Kaiwol1990/Mechaduino/schematics.png

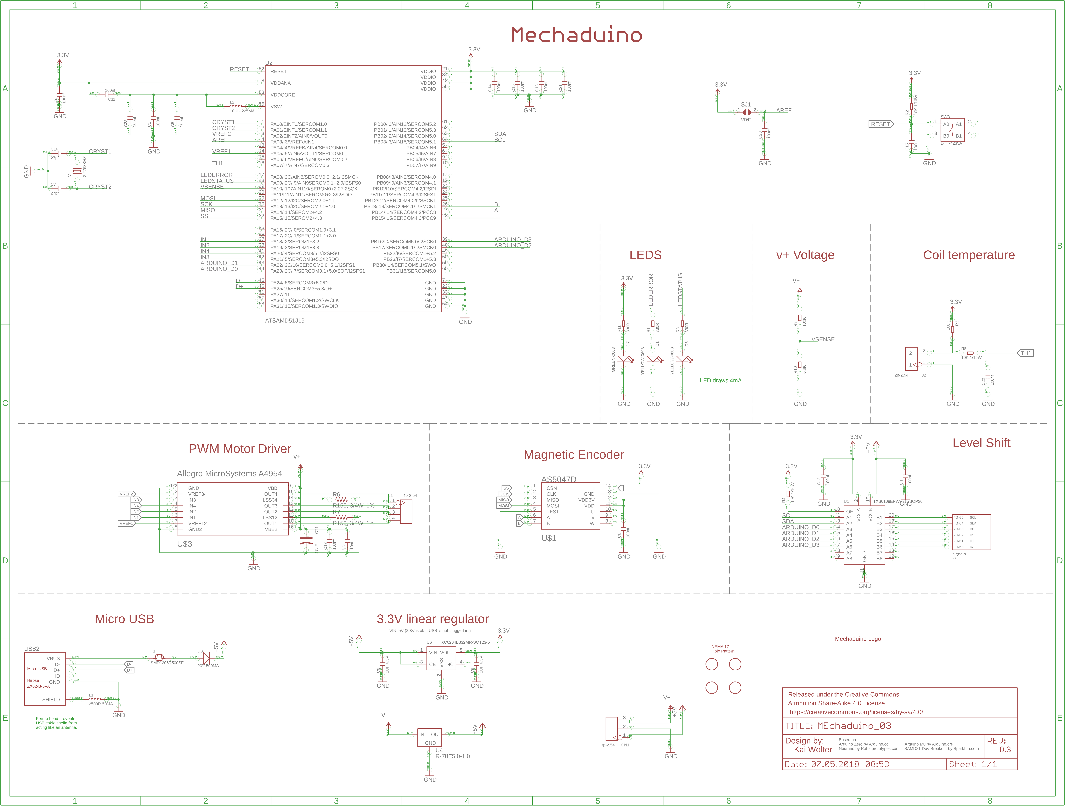
schematics.png
