Kaiwol1990/Mechaduino/(threads)

Thread 4 (2017-03-12):

Robodyn SAMD21 MINI board

LordVila, 2017-03-12:
Hello Kaiwol1990, first let me thank you for your help to the stepper servo drive world!

I'm currently working on a design based on the Mechaduino but for largers motors, using discrete MOSFETs instead of a dual H-bridge IC drive.

Got a Robodyn SAMD21 MINI board, since use the same microcontroller, and tried to upload your modified code version of Mechaduino but I'm not getting anything on the serial monitor, while the original code from Mechaduino works great. Any idea what could it be?

Kaiwol1990, 2017-03-25:
Hi LordVila,

sry for not answering. I'm not sure why you aren't getting anything from the SerialPort.
It's basically using the same Port as the original Firmware. Make sure you set the baudrate right and change your Serialparser to send a "\n" after every new line.

Closed 2017-04-08.

Thread 9 (2017-08-22):

0.9 degree stepper not working

Elvenblood, 2017-08-22:
Hi,

I can't get my 0.9 stepper to work with this release. It works somewhat better with the old version.
It runs through the calibration-process, but i get maximal error of around 70%. But I don't get any data for the lookup table and it sort of hangs.

With this version when trying to calibrate I get: "...Motor is not moving -> abbort"
It starts to move but don't really move at all, just oscillates.

Also, mm_rev what should the correct value be?

Thanks for any info

Kaiwol1990, 2017-08-23:
Hi Elvenblood,

I will take a look at what's going on. There are some bugs in the calibration routine I think.

The mm_rev value is only needed for the maximal error term and for the velocity settings of the downhill simplex algorithm. It's used for a motor with a pulley. If you don't have a pulley that turns the rotation into a linear movement, just set it to 360 and the velocity can be set in deg/s.

Kaiwol1990, 2017-08-23:
I've uploaded a new Version to the dev branch. Can you please try it for me?
If it's still not working try the command "calibrate -debug" and upload the output as a file.

Elvenblood, 2017-08-23:
Thanks for your help. Right now I had to get my 3d printer operational again so I switched back to my old setup. But I will try it as soon as I can. Probably this weekend. I tried it with 1.8 degrees with slightly better results. After a couple of layers it all jumps a few steps in som direction and I need to stop the print. This is the 3rd time I've tried to use the mechaduino and the 3rd set of motors, so I slowly loose hope of ever getting it to work.

I have 20 tooth gt2 pulleys and belts for my core-xy printer running it with 16 microstepping. What should the mm be then?

Thanks again and I'll try to give you the result as soon as I can.

Kaiwol1990, 2017-08-23:
The mm_rev would be 40 in that case.

The jumps could be a bad lookup table or bad PID settings. Make sure to try the downhill simplex algorithm to tune the motor. You can find it in the autotune tab.

Did you glue the magnet to the shaft as centered as possible?

_Sent from my OnePlus ONEPLUS A3003 using [FastHub](https://play.google.com/store/apps/details?id=com.fastaccess.github)_

Elvenblood, 2017-08-23:
Yes I tried the downhill which tuned it good as far as I could see. But I'll try it again. Yes I've tried glueing and not glueing and tweaking the mechaduino up down left right to no avail. I'll try to make a shim with my 3d printer and see if i can make it even more centered,

Btw nice work with firmwara end the GUI for tuning it. Makes the product a lot better.

/E

Kaiwol1990, 2017-08-24:
Thanks,
I glued the magnets all without a shim, just by hand and it works pretty well for me.
While tuning with the downhill simplex make sure to set the velocity to your average printing speed.
And while calibrating it is important that there is no load on the motors ( no belts attached) but I'm sure you know that. Let me know if it works.

- Kai

Elvenblood, 2017-08-26:
Hello,

The calibration now works. I don't know how accurate it is since the calibration report didn't show the number any more. How can I check the lookup table for errors?

Thanks for the fix. I'll run the downhill autotune later tonight and try som prints and see if it behaves.

/E

Kaiwol1990, 2017-08-27:
I've uploaded a new version to the dev branch.
if you send a "calibration -check" the mechaduino will step two times through all steps and checks the readings. You then can decide if you want to continue or not.
You can also send a "-smooth" with it to smooth the calibration table a little bit. This can help with a quieter operation of the mechaduino.

Kaiwol1990, 2017-08-28:
Hi Elvenblood,

I found another bug in the calibration. The coil current wasn't set right to do the full steps. I also implemented that the motor moves in both directions to compensate that it might want to move more in one direction.

Could you please check it?

Thanks.
Kai

Elvenblood, 2017-08-29:
Sorry for the late reply. But sure i'll try it as soon as I have moment over.

/E

Closed 2017-09-08.

Thread 12 (2020-01-26):

Incorrect handling of AS5047 ?

ctolzane, 2020-01-26:
Hi,
In order to make the readEncoderDiagnostics function to work I have to comment the lines below in Serial.cpp. Problem seen in master and dev branches. Why do you read twice?
Christophe.

**void readEncoderDiagnostics(int arg_cnt, char** args) {
	disableTC5Interrupts();
	disableTC4Interrupts();
	long angleTemp;

	SerialUSB.println(diagnostics_header);

	digitalWrite(chipSelectPin, HIGH);
	delay(1);
	digitalWrite(chipSelectPin, LOW);

	SPI.transfer(0xFF);
	SPI.transfer(0xFC);

	digitalWrite(chipSelectPin, HIGH);
	delay(1);
	digitalWrite(chipSelectPin, LOW);

	byte b1 = SPI.transfer(0xC0);
	byte b2 = SPI.transfer(0x00);

//	digitalWrite(chipSelectPin, HIGH);
//	delay(1);
//	digitalWrite(chipSelectPin, LOW);
//
//	b1 = SPI.transfer(0xC0);
//	b2 = SPI.transfer(0x00);**
