Kaiwol1990/Mechaduino/MEchaduino_03.brd

## EAGLE design MEchaduino_03.brd (2018-05-07)

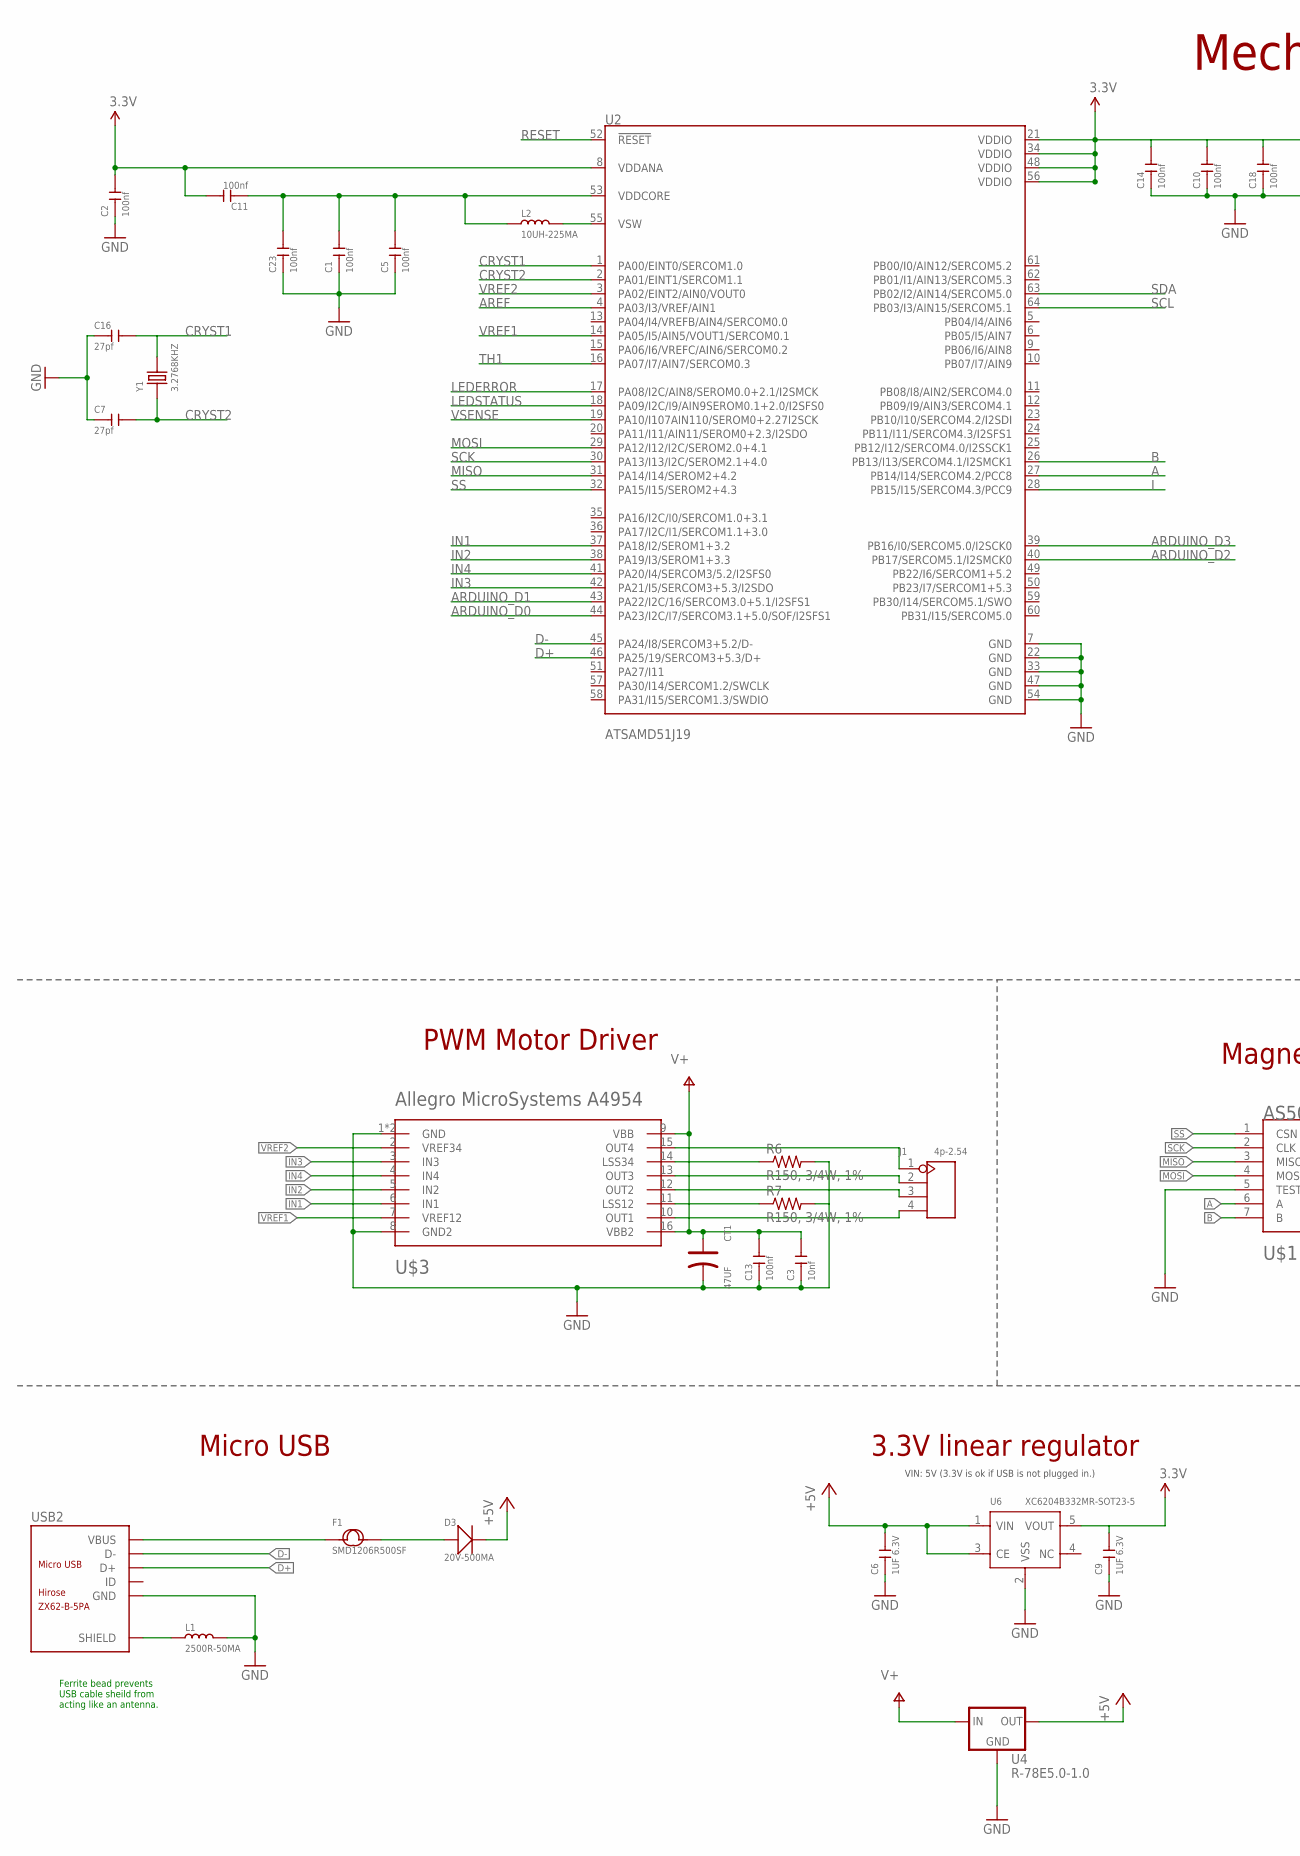
[picture p4: schematic MEchaduino_03.sch, part in row 1, column 1]

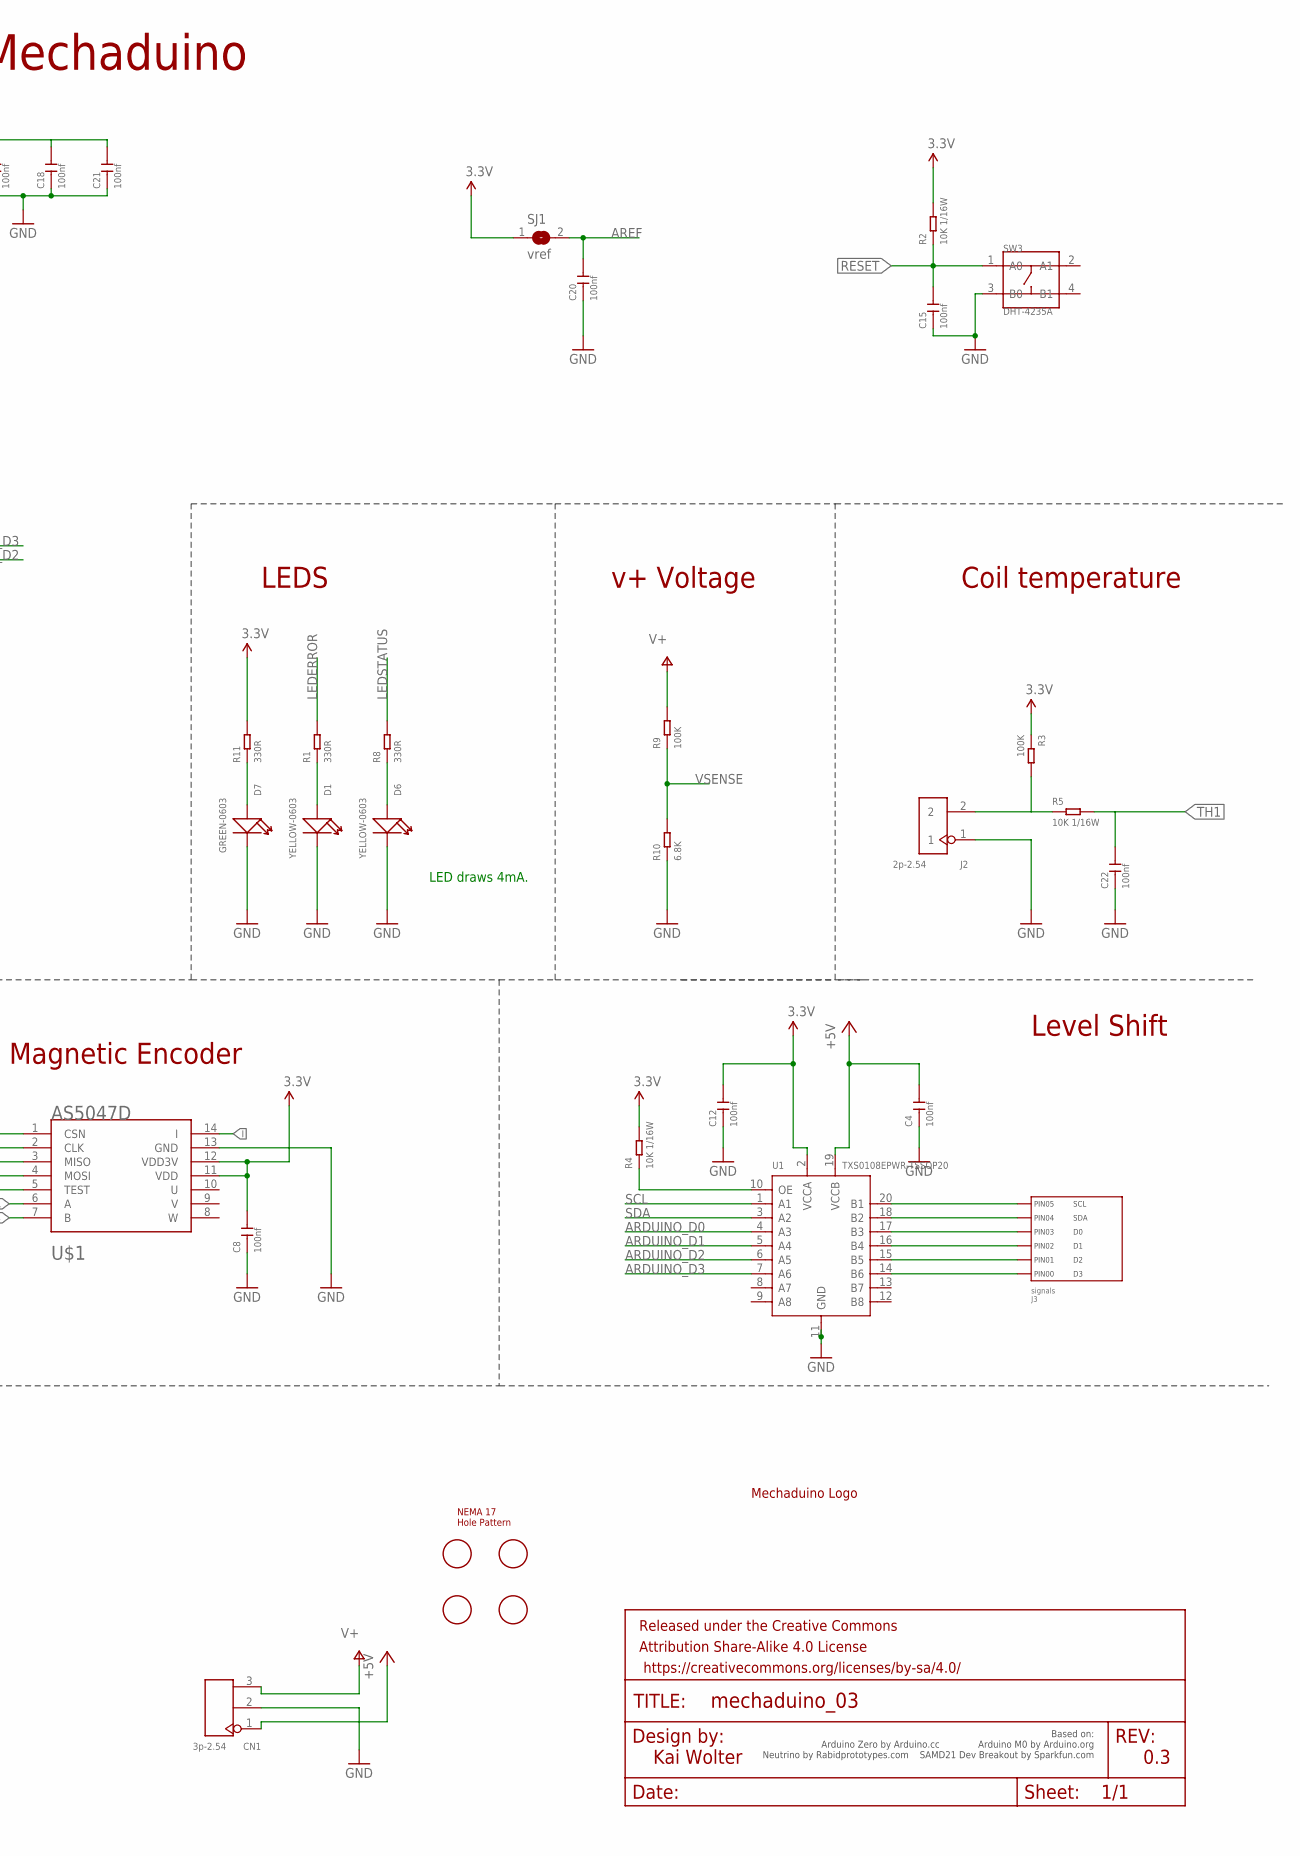
[picture p5: schematic MEchaduino_03.sch, part in row 1, column 2]

Parts:
C1, C2, C4, C5, C8, C10, C11, C12, C14, C15, C18, C20, C21, C22, C23: 100nf; C0402
C3: 10nf; C0603
C6, C9: 1UF 6.3V; C0402
C7, C16: 27pf; C0402
C13: 100nf; C0603
CN1: 3p-2.54; H3-2.54
CT1: 47UF; ELECTRO-SMD-C-6MM
D1, D6: YELLOW-0603; LED-0603
D3: 20V-500MA; SOD-123
D7: GREEN-0603; LED-0603
F1: SMD1206R500SF; F1206
FRAME1: FRAME-LEDGER; CREATIVE_COMMONS
J1: 4p-2.54; H4-2.54
J2: 2p-2.54; H2-2.54
J3: signals; PTH_2.54MM_01X06
L1: 2500R-50MA; L0603
L2: 10UH-225MA; L0806
R1, R8, R11: 330R; R0402
R2, R4, R5: 10K 1/16W; R0402
R3, R9: 100K; R0402
R6, R7: R150, 3/4W, 1%; R1206; MPN KRL1632E-M-R150-F-T5
R10: 6.8K; R0603
SJ1: vref; SJ
SW3: DHT-4235A; SW4-SMD-4.2X3.2X2.5MM
U1: TXS0108EPWR-TSSOP20; TSSOP20-0.65-6.5X4.4MM
U2: ATSAMD51J19; TQFP64; MPN ATSAMD51J19A-AU
U4: R-78E5.0-1.0; DC-DC_CONVERTER_78XX
U6: XC6204B332MR-SOT23-5; SOT-23-5
U$1: AS5047D; TSSOP14; MPN AS5047D-ATSM
U$2: NEMA17_HOLE_PATTERNNEW; NEMA17_HOLE_PATTERN_2
U$3: Allegro MicroSystems A4954; TSSOP16_THERM; MPN A4953ELJTR-T
U$4: MECHADUINO_LOGO
USB2: ZX62-B-5PA; MICRO-USB5+6P-SMD-0.65-AB
Y1: 3.2768KHZ; X2-SMD-L2.0X1.2X0.55MM

Connections:
3.3V: C2.2, C8.2, C9.2, C10.2, C11.2, C12.2, C14.2, C18.2, C21.2, R2.2, R3.1, R4.2, R11.2, SJ1.1, U1.2 (VCCA), U2.8 (VDDANA), U2.21 (VDDIO), U2.34 (VDDIO), U2.48 (VDDIO), U2.56 (VDDIO), U6.5 (VOUT), U$1.11 (VDD), U$1.12 (VDD3V)
+5V: C4.2, C6.2, CN1.1, D3.-, U1.19 (VCCB), U4.VOUT (OUT), U6.1 (VIN), U6.3 (CE)
A: U2.27 (PB14/I14/SERCOM4.2/PCC8), U$1.6 (A)
ARDUINO_D0: U1.4 (A3), U2.44 (PA23/I2C/I7/SERCOM3.1+5.0/SOF/I2SFS1)
ARDUINO_D1: U1.5 (A4), U2.43 (PA22/I2C/16/SERCOM3.0+5.1/I2SFS1)
ARDUINO_D2: U1.6 (A5), U2.40 (PB17/SERCOM5.1/I2SMCK0)
ARDUINO_D3: U1.7 (A6), U2.39 (PB16/I0/SERCOM5.0/I2SCK0)
AREF: C20.2, SJ1.2, U2.4 (PA03/I3/VREF/AIN1)
B: U2.26 (PB13/I13/SERCOM4.1/I2SMCK1), U$1.7 (B)
CRYST1: C16.2, U2.1 (PA00/EINT0/SERCOM1.0), Y1.2
CRYST2: C7.2, U2.2 (PA01/EINT1/SERCOM1.1), Y1.1
D+: U2.46 (PA25/19/SERCOM3+5.3/D+), USB2.3 (D+)
D-: U2.45 (PA24/I8/SERCOM3+5.2/D-), USB2.2 (D-)
GND: C1.1, C2.1, C3.1, C4.1, C5.1, C6.1, C7.1, C8.1, C9.1, C10.1, C12.1, C13.1, C14.1, C15.1, C16.1, C18.1, C20.1, C21.1, C22.1, C23.1, CN1.2, CT1.-, D1.-, D6.-, D7.-, J2.1, L1.2, R6.2, R7.2, R10.1, SW3.3 (B0), U1.11 (GND), U2.7 (GND), U2.22 (GND), U2.33 (GND), U2.47 (GND), U2.54 (GND), U4.GND, U6.2 (VSS), U$1.5 (TEST), U$1.13 (GND), U$3.1 (GND), U$3.8 (GND2), U$3.P$1 (GND), USB2.5 (GND)
I: U2.28 (PB15/I15/SERCOM4.3/PCC9), U$1.14 (I)
IN1: U2.37 (PA18/I2/SEROM1+3.2), U$3.6 (IN1)
IN2: U2.38 (PA19/I3/SEROM1+3.3), U$3.5 (IN2)
IN3: U2.42 (PA21/I5/SERCOM3+5.3/I2SDO), U$3.3 (IN3)
IN4: U2.41 (PA20/I4/SERCOM3/5.2/I2SFS0), U$3.4 (IN4)
I_SENSE_COIL_A: R7.1, U$3.11 (LSS12)
I_SENSE_COIL_B: R6.1, U$3.14 (LSS34)
LEDERROR: R1.2, U2.17 (PA08/I2C/AIN8/SEROM0.0+2.1/I2SMCK)
LEDSTATUS: R8.2, U2.18 (PA09/I2C/I9/AIN9SEROM0.1+2.0/I2SFS0)
MISO: U2.31 (PA14/I14/SEROM2+4.2), U$1.3 (MISO)
MOSI: U2.29 (PA12/I12/I2C/SEROM2.0+4.1), U$1.4 (MOSI)
unnamed: D6.+, R8.1
unnamed: J3.P$4 (PIN3), U1.17 (B3)
unnamed: D1.+, R1.1
unnamed: J3.P$3 (PIN2), U1.16 (B4)
unnamed: J3.P$2 (PIN1), U1.15 (B5)
unnamed: R4.1, U1.10 (OE)
unnamed: J3.P$1 (PIN0), U1.14 (B6)
unnamed: C1.2, C5.2, C11.1, C23.2, L2.1, U2.53 (VDDCORE)
unnamed: J3.P$6 (PIN5), U1.20 (B1)
unnamed: L2.2, U2.55 (VSW)
unnamed: D7.+, R11.1
unnamed: D3.+, F1.2
unnamed: J1.1, U$3.15 (OUT4)
unnamed: J1.4, U$3.10 (OUT1)
unnamed: J1.3, U$3.12 (OUT2)
unnamed: J1.2, U$3.13 (OUT3)
unnamed: J3.P$5 (PIN4), U1.18 (B2)
unnamed: J2.2, R3.2, R5.1
RESET: C15.2, R2.1, SW3.1 (A0), U2.52 (!RESET!)
SCK: U2.30 (PA13/I13/I2C/SEROM2.1+4.0), U$1.2 (CLK)
SCL: U1.1 (A1), U2.64 (PB03/I3/AIN15/SERCOM5.1)
SDA: U1.3 (A2), U2.63 (PB02/I2/AIN14/SERCOM5.0)
SHIELD: L1.1, USB2.P1 (SHIELD), USB2.P2 (SHIELD), USB2.P3 (SHIELD), USB2.P4 (SHIELD), USB2.P5 (SHIELD), USB2.P6 (SHIELD)
SS: U2.32 (PA15/I15/SEROM2+4.3), U$1.1 (CSN)
TH1: C22.2, R5.2, U2.16 (PA07/I7/AIN7/SERCOM0.3)
V+: C3.2, C13.2, CN1.3, CT1.+, R9.2, U4.VIN (IN), U$3.9 (VBB), U$3.16 (VBB2)
VBUS: F1.1, USB2.1 (VBUS)
VREF1: U2.14 (PA05/I5/AIN5/VOUT1/SERCOM0.1), U$3.7 (VREF12)
VREF2: U2.3 (PA02/EINT2/AIN0/VOUT0), U$3.2 (VREF34)
VSENSE: R9.1, R10.2, U2.19 (PA10/I107AIN110/SEROM0+2.27I2SCK)

Notes on the sheet:
LED draws 4mA.
Ferrite bead prevents USB cable sheild from acting like an antenna.
3.3V linear regulator
Magnetic Encoder
PWM Motor Driver
VIN: 5V (3.3V is ok if USB is not plugged in.)
Micro USB
Kai Wolter
Based on: Arduino Zero by Arduino.cc Arduino M0 by Arduino.org Neutrino by Rabidprototypes.com SAMD21 Dev Breakout by Sparkfun.com
0.3
Mechaduino
Level Shift
Coil temperature
v+ Voltage
LEDS

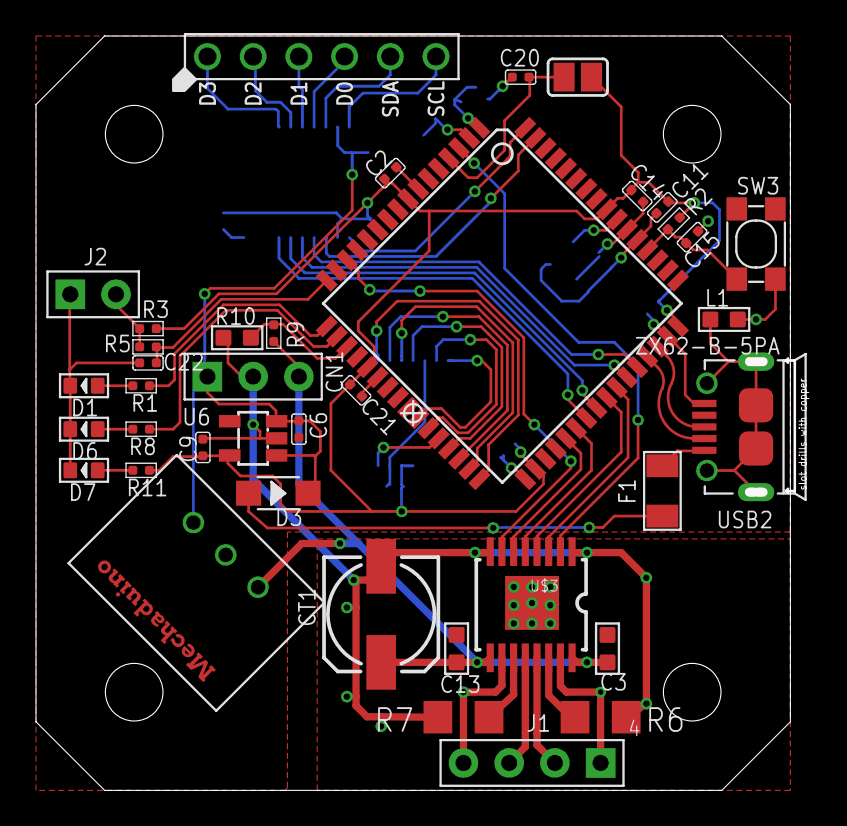
[picture p6: board MEchaduino_03.brd from above]

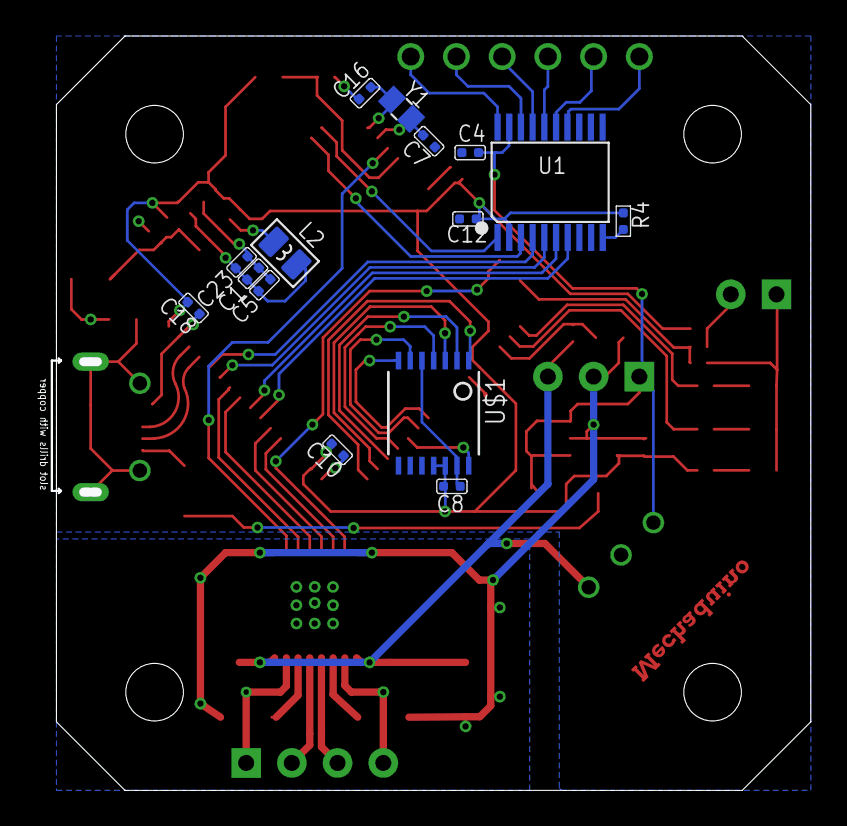
[picture p7: board MEchaduino_03.brd from below]

Board: 2 copper layers, 41.9 x 41.9 mm, 57 parts (15 on the bottom side), 55 nets.
