Kaiwol1990/Mechaduino/Standard_Mechaduino/Mechaduino_01/State.cpp

//Contains the declaration of the state variables for the control loop
#include <Wire.h>
#include "State.h"
#include "Parameters.h"


//---- interrupt vars ----
volatile int r = 0;                 //target angle
volatile int y = 0;                //current angle

volatile int raw_0 = 0;             // current measured angle
volatile int raw_1 = 0;             // last measured angle
volatile int raw_diff = 0;          // diff of both

volatile int u = 0;                 // control effort

volatile int e_0 = 0;               // current error term
volatile int e_1 = 0;               // last error term

volatile bool dir = true;           // flag for dir setting
volatile bool enabled = true;       // flag for enabled setting

bool frequency_test = false;        // flag for frequency test

//---- PID Gains ----
int big_Kp = (Kp * 2) / 10;
int big_Ki = Ki;
int big_Kd = (8 * Kd) / 3;

int small_Kp = (4 * Kp) / 5;
int small_Ki = Ki / 2;
int small_Kd = Kd / 5;

//----current settings-----
const float rSense = 0.150;                           // resistor value
const int uMAX = ((1024 * iMAX * 10 * rSense) / 3.3);  // max voltage for the vref pins
int ITerm_max = (uMAX * 1000) / (3 * Ki);
int phase_multiplier = (10 * steps_per_revolution / 4) / 100;

//---- Step settings -----
const int counts_per_revolution = 16384;                              // encoder counts for 360 degrees
const float angle_per_step = 360.0 / steps_per_revolution;            // only needed for calibration routine by now
const float stepangle = 36000.0 / (steps_per_revolution*microstepping);   // angle of one step as int
const int PA = (36000 / steps_per_revolution);                        // angle of one fullstep
volatile int step_target = 0;                                         // target as step gets incremented if an step is received


//--- lookup tables for the coils ---
const PROGMEM int_fast16_t sin_lookup[] = {724, 725, 727, 728, 729, 730, 732, 733, 734, 735, 737, 738, 739, 740, 742, 743, 744, 745, 746, 748, 749, 750, 751, 753, 754, 755, 756, 757, 759, 760, 761, 762, 763, 765, 766, 767, 768, 769, 770, 772, 773, 774, 775, 776, 777, 779, 780, 781, 782, 783, 784, 786, 787, 788, 789, 790, 791, 792, 794, 795, 796, 797, 798, 799, 800, 801, 803, 804, 805, 806, 807, 808, 809, 810, 811, 812, 813, 815, 816, 817, 818, 819, 820, 821, 822, 823, 824, 825, 826, 827, 828, 829, 831, 832, 833, 834, 835, 836, 837, 838, 839, 840, 841, 842, 843, 844, 845, 846, 847, 848, 849, 850, 851, 852, 853, 854, 855, 856, 857, 858, 859, 860, 861, 862, 863, 864, 865, 866, 867, 867, 868, 869, 870, 871, 872, 873, 874, 875, 876, 877, 878, 879, 880, 880, 881, 882, 883, 884, 885, 886, 887, 888, 889, 889, 890, 891, 892, 893, 894, 895, 896, 896, 897, 898, 899, 900, 901, 902, 902, 903, 904, 905, 906, 907, 907, 908, 909, 910, 911, 912, 912, 913, 914, 915, 916, 916, 917, 918, 919, 920, 920, 921, 922, 923, 923, 924, 925, 926, 927, 927, 928, 929, 930, 930, 931, 932, 933, 933, 934, 935, 935, 936, 937, 938, 938, 939, 940, 940, 941, 942, 943, 943, 944, 945, 945, 946, 947, 947, 948, 949, 949, 950, 951, 951, 952, 953, 953, 954, 955, 955, 956, 957, 957, 958, 959, 959, 960, 960, 961, 962, 962, 963, 963, 964, 965, 965, 966, 966, 967, 968, 968, 969, 969, 970, 971, 971, 972, 972, 973, 973, 974, 974, 975, 976, 976, 977, 977, 978, 978, 979, 979, 980, 980, 981, 981, 982, 982, 983, 983, 984, 984, 98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
const int dir_pin = 0;        //PORT_PA11
const int step_pin = 1;       //Port_PA10
const int ena_pin = 2;        //PORT_PA14


const float M_Pi = 3.1415926535897932384626433832795;

//--- PID autotuning variables ---
bool tune_running = false; //set flag for running indication
