Kaiwol1990/Mechaduino/Standard_Mechaduino/Mechaduino_01/Parameters.cpp

//Contains the Mechaduino parameter defintions
#include <Wire.h>
#include "Parameters.h"


//---- Identifier -----
const String identifier = "Y";   // string to identify the mechaduino with the Serial monitor

//---- PID Frequenz -----
const int FPID = 15000;  // frequency of the PID loop change only if you know what you're doing

//---- PID Values -----
volatile int Kp = 2151;
volatile int Ki = 54;
volatile int Kd = 21301;


//----current settings-----
const float iMAX = 1.0; // max current per coil 2.0 A for A4954 driver should be lower (thermal conditions)

//---- Lookup -----
//This is the encoder lookup table (created by calibration routine):
const PROGMEM int lookup[] = {18310 , 18312 , 18314 , 18317 , 18319 , 18321 , 18324 , 18326 , 18328 , 18330 , 18333 , 18335 , 18337 , 18339 , 18342 , 18344 , 18346 , 18349 , 18351 , 18353 , 18355 , 18358 , 18360 , 18362 , 18364 , 18366 , 18368 , 18371 , 18373 , 18375 , 18377 , 18379 , 18381 , 18383 , 18385 , 18388 , 18390 , 18392 , 18394 , 18396 , 18398 , 18400 , 18402 , 18404 , 18407 , 18409 , 18411 , 18413 , 18415 , 18417 , 18419 , 18421 , 18424 , 18426 , 18428 , 18430 , 18432 , 18434 , 18436 , 18438 , 18440 , 18443 , 18445 , 18447 , 18449 , 18451 , 18453 , 18455 , 18457 , 18460 , 18462 , 18464 , 18466 , 18468 , 18470 , 18472 , 18474 , 18476 , 18479 , 18481 , 18483 , 18485 , 18487 , 18489 , 18491 , 18493 , 18496 , 18498 , 18500 , 18502 , 18504 , 18506 , 18508 , 18510 , 18512 , 18515 , 18517 , 18519 , 18521 , 18523 , 18525 , 18527 , 18529 , 18532 , 18534 , 18536 , 18538 , 18540 , 18542 , 18545 , 18547 , 18549 , 18551 , 18554 , 18556 , 18558 , 18561 , 18563 , 18565 , 18567 , 18570 , 18572 , 18574 , 18576 , 18579 , 18581 , 18583 , 18586 , 18588 , 18590 , 18592 , 18595 , 18597 , 18599 , 18602 , 18604 , 18606 , 18608 , 18611 , 18613 , 18615 , 18617 , 18620 , 18622 , 18624 , 18627 , 18629 , 18631 , 18633 , 18636 , 18638 , 18640 , 18643 , 18645 , 18647 , 18649 , 18652 , 18654 , 18656 , 18658 , 18661 , 18663 , 18665 , 18668 , 18670 , 18672 , 18674 , 18677 , 18679 , 18681 , 18684 , 18686 , 18688 , 18690 , 18693 , 18695 , 18697 , 18699 , 18702 , 18704 , 18706 , 18709 , 18711 , 18713 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
