Kaiwol1990/Mechaduino/Standard_Mechaduino/Mechaduino_01/Utils.h

//Contains the declarations for the functions used by the firmware

#ifndef __UTILS_H__
#define __UTIL_H__

void setupPins();

void setupSPI();

void stepInterrupt();

void enaInterrupt();

void dirInterrupt();

void output(int theta, int effort) __attribute__ ((optimize("O3")));

void calibration();

void serialCheck();

void Serial_menu();

void setpoint();

void parameterQuery();

void oneStep();

int readEncoder();

int mod(int xMod, int mMod);

void setupTCInterrupts();

void enableTC5Interrupts();

void disableTC5Interrupts();

void parameterEdit();

void step_response();

void get_max_frequency();

void PID_autotune();

extern int digitalSmooth(int rawIn, int *sensSmoothArray);

void readEncoderDiagnostics(); //check encoder diagnostics registers

#endif
