Kaiwol1990/Mechaduino/(commit log)

2016-10-22 Add files via upload
    - Added an digital filter for the error.
    - deletet all loops other then position
    - fixed some menu issues
    - added menu for an step response
    [Controller.cpp, Mechaduino_01.ino, Parameters.cpp, Parameters.h, State.cpp, State.h, Utils.cpp, Utils.h]
2016-10-23 Add files via upload
    - deleted digital filter
    - changed digitalWrite commands to direct register manipulation (much faster)
    - changed frequenz from 3000 Hz to about 4500 Hz (no need for filtering anymore)
2016-10-24 fixed calibration routine
2016-10-24 changed some menus and made it easier to disable the enable pin
    - calibration routine now prints percent instead of encoder reading
    - enable pin can be disabled by simply setting it to -1
2016-10-25 mayor celan up and added an digital filter to the measured angle
2016-10-26 changed calibration routine to find zero point faster, added some time outs for the serial communication
2016-10-26 Stl to get the magnet closer to the motor shaft and to seperate it from the shaft
    [spacer.stl]
2016-10-28 Fixed some filtering errors that occured
    [Controller.cpp, Mechaduino_01.ino, Parameters.cpp, Parameters.h, State.cpp, State.h, Utils.cpp, Utils.h]
2016-10-29 Changed filterfrom butterworth to biquad
    The biquad filter shows no overshoot, so theres les overshoot in the PID
    loop aswell.
    Also made it possible to change the filter frequence on the fly
    [Mechaduino_01.ino, Parameters.cpp, Parameters.h, State.cpp, State.h, Utils.cpp, Utils.h]
2016-10-30 Delevoment Branch
    Moved the encoder reading in an extra interrupt that runs about 40kHz
    and filtering it down to the PID loop frequency. Gets very quiet since
    the angle get mutch smoother
2016-10-30 PID tuned
2016-10-31 implemented an IIR Filter instead of an biquad for faster performance, cleanup
2016-11-01 fixed the setpoint function
    [Utils.cpp]
2016-11-01 fixed overflow error for controller effor
    [Controller.cpp, Parameters.cpp, State.cpp, State.h, Utils.cpp]
2016-11-03 Fixed an bitshift error
    [Mechaduino_01.ino, Parameters.cpp, Utils.cpp]
2016-11-05 Merged DEveloment in Master
    - way faster Performance (sample 50kHz, PID 8.5 kHz)
    - easier enablepin setup
    - some coe cleanup
2016-11-18 added donation button
2016-11-18 fixed some plot bugs
    [step_response.pde]
2016-11-18 Changed the PWM resolution to 12 bit
    The SAM21 can write PWM values with 12 bit instead of 8 bit, so we get much better resolutions for the coil currents with 12 bit and also much better control over the max current.
    example:
    i_max = 0.6 Amps
    with 8 bit pwm settings from 0 to max 69
    with 12 bit pwm settings from 0 to 1117
2016-11-19 Added an Autotune function
    It's not workin perfectly but it gives some number so work with.
    [Controller.cpp, Mechaduino_01.ino, Parameters.cpp, Parameters.h, State.cpp, State.h, Utils.cpp]
2016-11-19 Bugfix in the noise detection for the autotune
    [Utils.cpp]
2016-11-19 calculationg the classic pid values to one with less overshoot
    [Controller.cpp, Parameters.cpp, Utils.cpp]
2016-11-19 reading the angle without DAEC to get less noise
    [Parameters.cpp, Utils.cpp]
2016-11-19 changed DAEC back got some strange bugs
    [Utils.cpp]
2016-11-19 added an minimal cutoff current
    changed some parameters and added an minimal cutoff current
2016-11-19 Deleted min current cutoff, made some things worse
2016-11-20 Fixed some major problems with the autotune function
    [Controller.cpp, Parameters.cpp, State.cpp, State.h, Utils.cpp]
2016-11-22 Bugfix in autotune function
    [Parameters.cpp, Utils.cpp]
2016-11-23 rewritten the whole autotune function to use another (more stable) method
    changed the autotune method from an interactive type to a passive.
    At first the system will be oscillated and then this oscillation will be
    analyzed and based on that calculation the PID settings will be
    calculated.
    [Parameters.cpp, Utils.cpp, Utils.h]
2016-11-23 bugfix for 400 step motors
    [State.cpp]
2016-11-23 potential bugfix for 400 steps motors
    [State.cpp]
2016-11-24 bugfix for 400 step/rev motor
    [State.cpp]
2016-11-25 Changed PID frequency and made it easyer to change o 400 steps/rev motors
2016-11-26 added cos_lookup for coil current and made the pid autotune faster
2016-11-26 Chaged back to one pid loop
2016-11-26 calculating maximal ITerm based on PID settings
2016-11-27 changed stepangle from int to float to get more accurate target calculation
    if using high microstepping the stepangel gets too small to perform
    integer calculations, so i changed it to float. makes everything a
    little slower (can get up to 18 kHz with 200 steps/mm an 200 mm/s) but
    gives more precision.
    [Parameters.cpp, State.cpp, State.h]
2016-12-01 small changes to the pid autotune
2016-12-06 Some code cleanup and a second pid loop for small errors integrated
    Big cleanup of the Serial interface
    [Controller.cpp, Mechaduino_01.ino, Parameters.cpp, State.cpp, State.h, Utils.cpp, Utils.h]
2016-12-10 Big Update!
    [Configuration.h, Configurationals.h]
2016-12-10 bug fixes after update
    [Configuration.h, Configurationals.h]
2016-12-11 clean up
    [Configurationals.h]
2016-12-13 further improvment of the Serial communication
    [Configuration.h]
2016-12-26 Changed the serial communication
    still working on the pid autotune to improve the stability
    [Configuration.h]
2017-01-06 Filters and RAS added
    - Added some Filters to the PID loop
    - implemented an RAS.
    - feedforward loop integrated, since the RAS bufferst the target it's
    possible to calculate the target speed
    [Configuration.h]
2017-01-08 Added simple inertia term
    [Configuration.h]
2017-01-14 better implementation of the inertia compensation and new response function to use with arduino ide and without processing
    [Configuration.h]
2017-01-15 improved autotune and inertia compensation
    - now tunes friction aswell
    - inertia terms for rotor inertia and inertia of the load
    - better configuration file layout
    [Configuration.h, Configurationals.h]
2017-01-15 small bug fix
    [Configuration.h]
2017-01-19 Updated the calibration to run 3 loops and avarage the readings, gives better results
    [Configuration.h]
2017-01-20 further improvment for the calibration
    [Configuration.h]
2017-01-21 fixed editparam menu and further improvment of the calibration
    [Configuration.h, Configurationals.h]
2017-01-22 small changes int the controller code
    [Configuration.h]
2017-01-23 small Bug fixes
    [Configuration.h]
2017-01-27 fix for overflow at high angles and dynamic phase advance
    [Configuration.h]
2017-01-27 bug fix for high angles
    [Controller.cpp]
2017-01-29 deleted PIV setting
    deleted PIV setting since the controller works all the time with the velocity
    [Configuration.h]
2017-01-29 small changes
    the calibration routine prints the original mesaured values for the
    fullstep positons
2017-02-02 smoothing integrated into calibration
    the smoothing of the lookup table is now integrated into the calibration routine
    + new Serial boot logo
    [Configuration.h]
2017-02-03 bug fix in the inertia compensation terms
    [Configuration.h, Configurationals.h]
2017-02-04 small cleanup
    [Configuration.h]
2017-02-04 added check routine for the lookup table
    [Configuration.h]
2017-02-22 edit of the boot to start the motor without jerking at boot
2017-03-05 added second pid controller for the phase advanced
    added a second pid controller that calculates the phase advanced based on the error and target speed. Had to reduce the overall loop speed to calculate both pid controllers.
    [Configuration.h]
2017-03-09 some small changes
    - the step response now also plots the target angle
    - there is a streaming option that outputs some parameters all the time while it's active
    - some changes to the pid loop speed
    [Configuration.h]
2017-04-01 added support for dynamic changing of settings
    [Configurationals.h]
2017-04-08 Changed some variale types
    [Configurationals.h]
2017-04-10 implemented a simple state controller
    [Configuration.h, Configurationals.h]
2017-04-13 deleted the state controller since it was buggy
    [Configuration.h, Configurationals.h]
2017-04-21 GUI and Firmware update
    GUI now supports exporting the configuration file and the firmware hase
    two more Low pass filters implemented for quieter operation.
    [Configuration.h]
2017-05-01 bug fix for serial menus
    The serial menu allows now to change all low pass filter frequencies
    [Controller.cpp, State.cpp]
2017-05-02 Streaming now works with about 250 Hz instead of 100 Hz
2017-05-02 Serial was streaming with 200 Hz instead of 250 Hz -> now fixed
2017-05-05 GUI and firmware update
    The GUI and new firmware now support to change the sample rate while
    performing a step response.
    The GUI now supports to export the collected data from a step respnse as
    csv or txt file.
    Note:
    The firmware need to be updated aswell.
2017-06-10 angle reading placed in it's own intterupt
    the angle gets updated with it's own interrupt routine
    - oversampling the angle with 2 time pid frequency
    - the angle is updated even if the controller interrupt is switched off
    -> makes (for example) the autotune function easier
2017-06-22 Deleted some filters
2017-06-22 Deleted some filters and implemented an simple error register
    [Configuration.h, Configurationals.h]
2017-06-22 Error register and no more PROGMEM variables
    added an error "register" (bitwise errorflags in one integer)
    deleted all PROGMEM variables
    [Controller.cpp, State.cpp, State.h, Utils.cpp, Utils.h]
2017-06-22 fixes in the calibration routine and error led implementation
    - small fixes in code
    - small fixes in the calibration routine
    - the led shows now if and what error is occured by blinking in
    different pattern
    [Controller.cpp, Utils.cpp, Utils.h]
2017-06-23 renamed folder
    [Configuration.h, Configurationals.h]
2017-06-23 change in LED pattern
2017-06-23 LED pattern update
2017-06-23 clean up
    - Deleted some unnecessary #include
    - Deleted some unnecessary variables
    [Configurationals.h]
2017-06-26 bugfix in auotune function
    deleted a line where the autotune function was called with the PID frequency -> restored that line should work again
    [Utils.cpp]
2017-06-26 added second pid controller for small errors and low velocity
    second pid loop pased on pessen variables
    [Configuration.h]
2017-07-18 Autotune update & feedforward
    - implemented a twiddle algorithm to finetune the pid values
    - implemented a downhill simplex algorithm to finetune the pid values
    - added feedforward and acceleration gains
    - added global omega (velocity)
    - phase angle is caculated based on omega to compensate for the lag of
    the controller
    [Configuration.h]
2017-07-22 gui update
    The gui can now plot more variables for tuning
    - velocity
    - velocity error
    - position and position error
    There is also a new test move pattern for motor tuning
    [Utils.cpp]
2017-07-22 bug fix in the calibration routine
    [Utils.cpp]
2017-07-24 GUI Update
    - It's now able to select the streamed variables. Also, there is the
    possibility to stream 2 variables in each plot.
    - Added an argument to the calibration routine to start it without a
    check of the direction
    [Configuration.h]
2017-08-10 GUI and Communication Update
    -new tab in the gui to run the downhill simplex algorithm, that tunes
    the pid settings
    - communication update. identifiert at the begining of streamed
    parameters for easier identification with the gui
2017-08-14 Code and variable clean up
    - deleted some unused variables and redefined the lookup as uint16_t to save space
    - used #define to implement the serial commands for easier change in Language.h file
    - other small cleanups
    [Configuration.h, Configurationals.h]
2018-04-25 Hardware update
    Hardware update
    [MEchaduino_03.brd, MEchaduino_03.kicad_pcb, MEchaduino_03.sch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]
2018-04-26 changed microcontroller to ATSAMD51J19
    [MEchaduino_03.brd, MEchaduino_03.sch, Mechaduino02_BOM.csv]
2018-04-27 implemted voltage sense pin and some leds
    [MEchaduino_03.brd, MEchaduino_03.sch]
2018-04-30 Rearange to fit old pin positions
    [MEchaduino_03.brd, MEchaduino_03.sch]
2018-05-04 finished design
    [MEchaduino_03.brd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]
2018-05-07 Finalized version of PCB for manufacturing
    [Bom_seeed.csv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]
